denisgav/STM32F405RGT6_BlackPill/doc/production/Impedance Control.odt

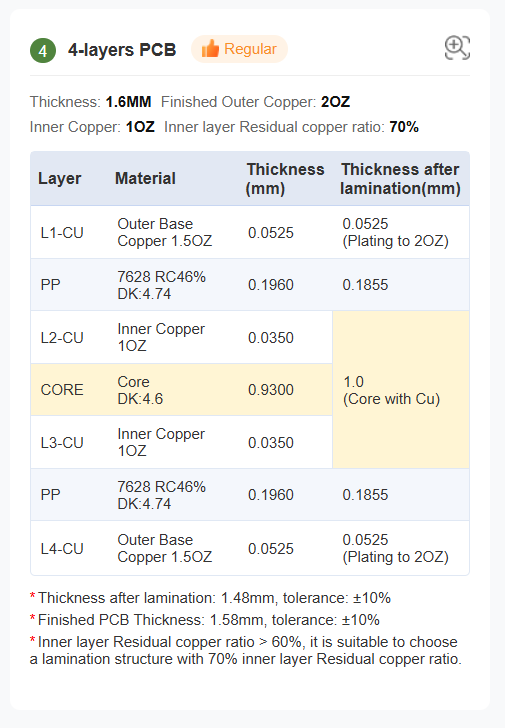
[picture p1: figure]
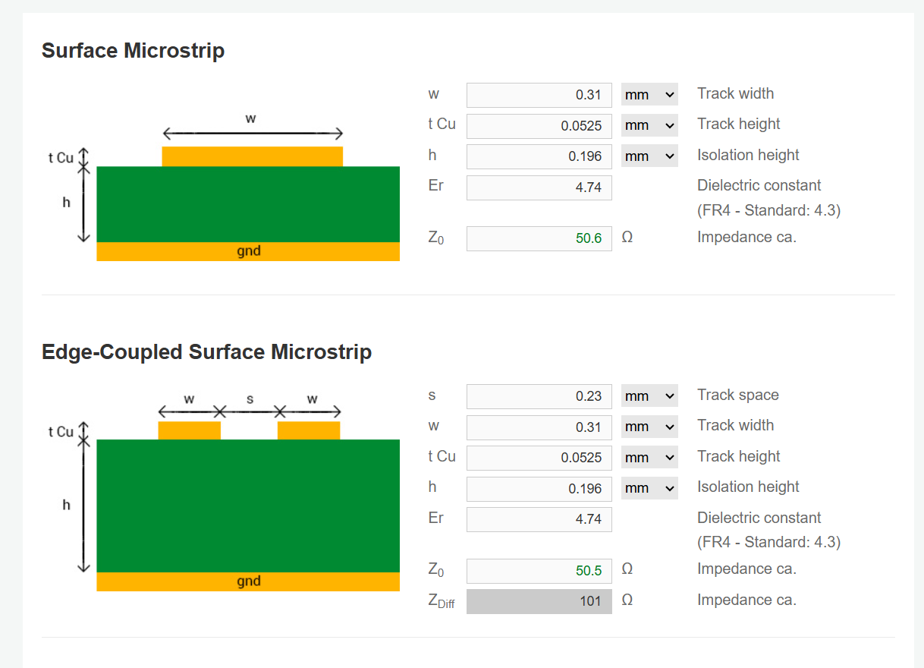
[picture p2: figure]
