denisgav/STM32F405RGT6_BlackPill/STM32F405RGT6_BlackPill/components/HRO  TYPE-C-31-M-12.step

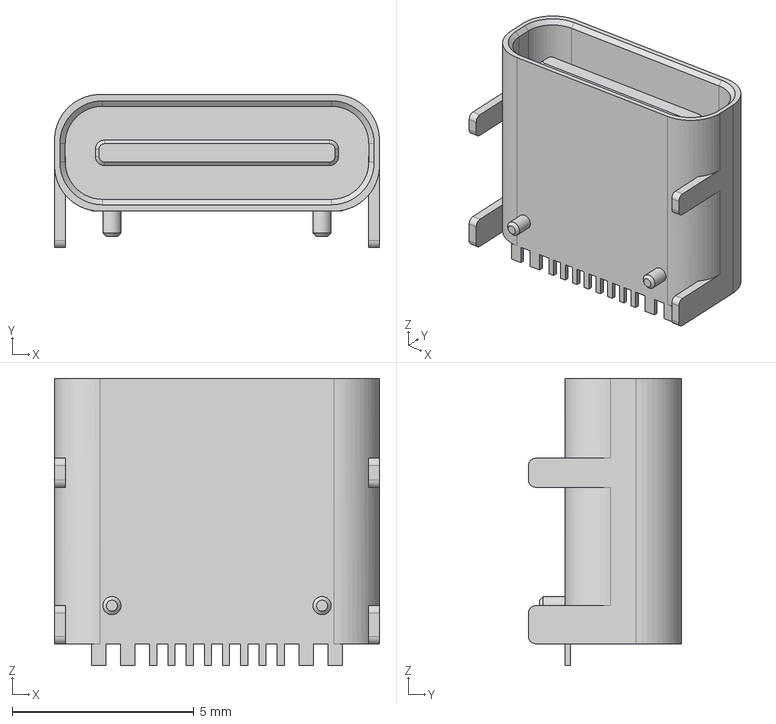
[picture p3: CAD file, 2024-12-23]
STM32F405RGT6_BlackPill/components/HRO TYPE-C-31-M-12.step
8.94 x 4.21 x 7.90 mm
