denisgav/STM32F405RGT6_BlackPill/STM32F405RGT6_BlackPill/components/SMT_0-2P-T001_TDK.step

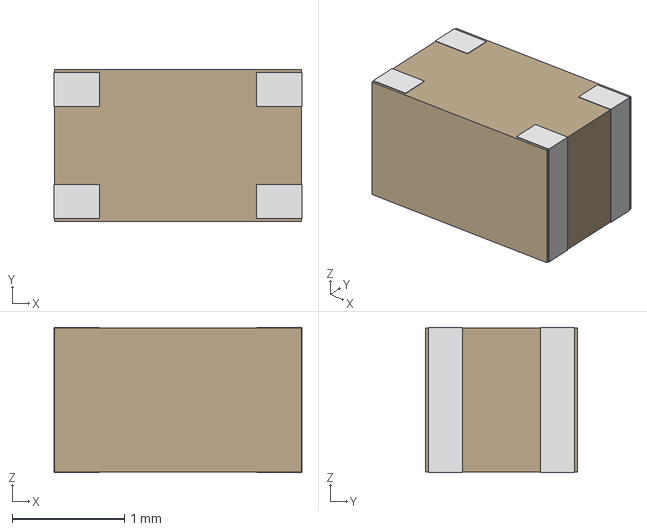
[picture p4: CAD file, 2024-12-23]
STM32F405RGT6_BlackPill/components/SMT_0-2P-T001_TDK.step
2.21 x 1.36 x 1.29 mm
