denisgav/STM32F405RGT6_BlackPill/STM32F405RGT6_BlackPill/components/SW_PUSH_6mm_H5mm.step

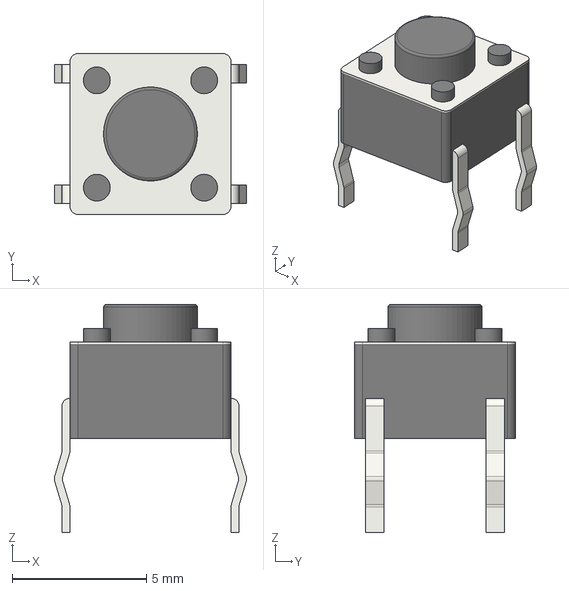
[picture p5: CAD file, 2024-12-22]
STM32F405RGT6_BlackPill/components/SW_PUSH_6mm_H5mm.step
7.17 x 6.00 x 8.50 mm
