denisgav/STM32F405RGT6_BlackPill/STM32F405RGT6_BlackPill/components/12402012E212A.step

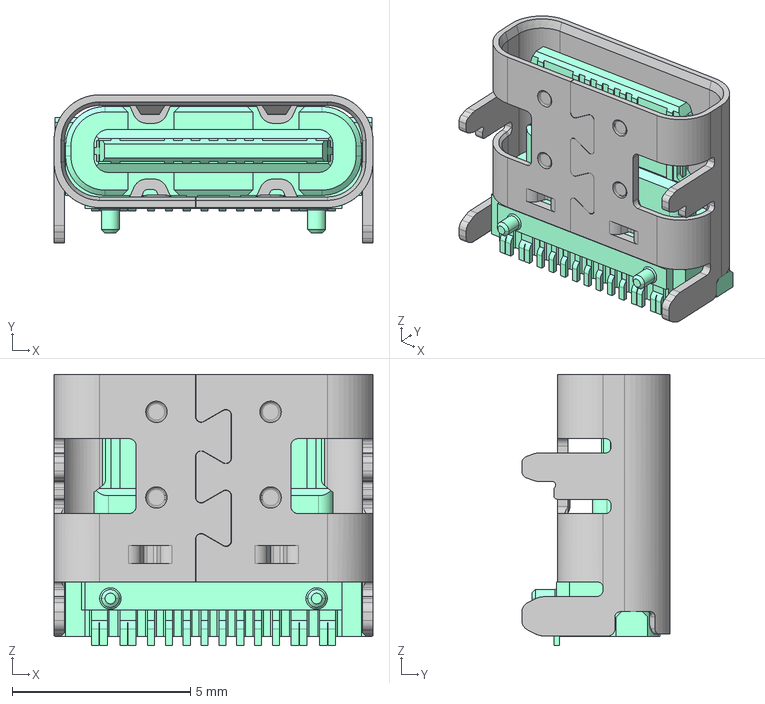
[picture p6: CAD file, 2024-12-23]
STM32F405RGT6_BlackPill/components/12402012E212A.step
8.94 x 4.16 x 7.60 mm
