denisgav/STM32F405RGT6_BlackPill/STM32F405RGT6_BlackPill/STM32F405RGT6_BlackPill.kicad_pcb

## KiCad design STM32F405RGT6_BlackPill/STM32F405RGT6_BlackPill.kicad_pcb (2024-12-26)

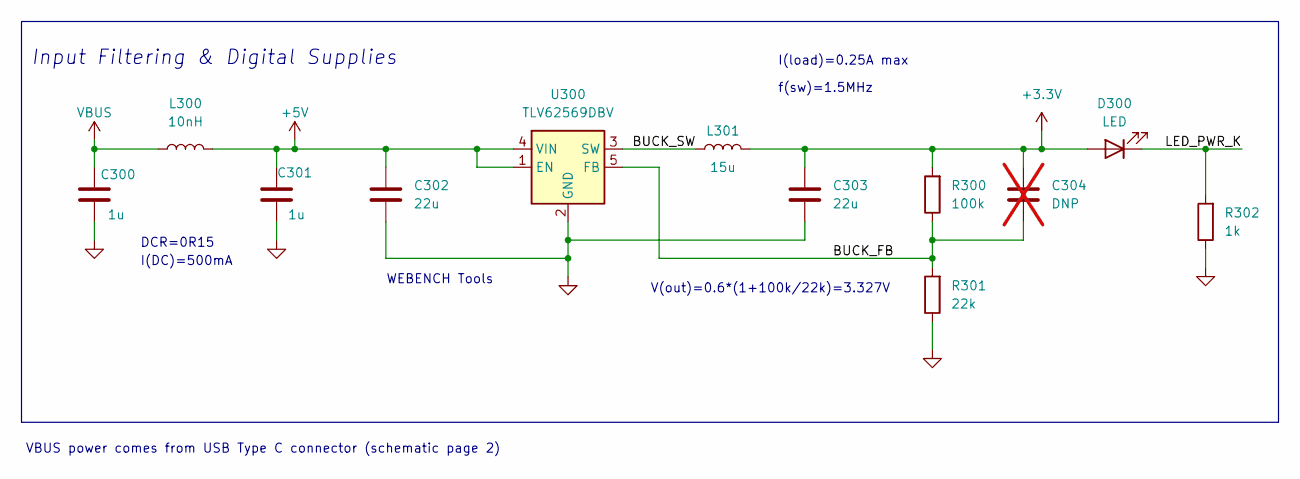
[picture p7: schematic power.kicad_sch]

Parts:
C300, C301: 1u; C_0603_1608Metric; DigiKey Part Number 1276-1946-6-ND
C302, C303: 22u; C_0805_2012Metric; DigiKey Part Number 1276-6687-6-ND
C304: DNP; C_0402_1005Metric; not fitted
D300: LED; LED_0603_1608Metric; DigiKey Part Number 732-4971-6-ND
L300: 10nH; L_0402_1005Metric; DigiKey Part Number 712-LRC0402CJ10NGV001TDKR-ND
L301: 15u; MWSA0603S; DigiKey Part Number 3442-MWSA0603S-150MTDKR-ND
R300: 100k; R_0402_1005Metric; DigiKey Part Number P100KLDKR-ND
R301: 22k; R_0402_1005Metric; DigiKey Part Number P22.0KLDKR-ND
R302: 1k; R_0402_1005Metric; DigiKey Part Number P1.00KLDKR-ND
U300: TLV62569DBV; SOT-23-5; DigiKey Part Number 296-47360-6-ND

Connections:
+3.3V: C303.1, C304.1, D300.2 (A), L301.2, R300.2; also elsewhere on the board
+5V: C301.1, C302.1, L300.2, U300.1 (EN), U300.4 (VIN); also elsewhere on the board
/power/BUCK_FB: C304.2, R300.1, R301.2, U300.5 (FB)
/power/BUCK_SW: L301.1, U300.3 (SW)
/power/LED_PWR_K: D300.1 (K), R302.2
GND: C300.2, C301.2, C302.2, C303.2, R301.1, R302.1, U300.2 (GND); also elsewhere on the board
VBUS: C300.1, L300.1; also elsewhere on the board

Notes on the sheet:
f(sw)=1.5MHz
V(out)=0.6*(1+100k/22k)=3.327V
VBUS power comes from USB Type C connector (schematic page 2)
I(load)=0.25A max
DCR=0R15
WEBENCH Tools
Input Filtering & Digital Supplies
I(DC)=500mA

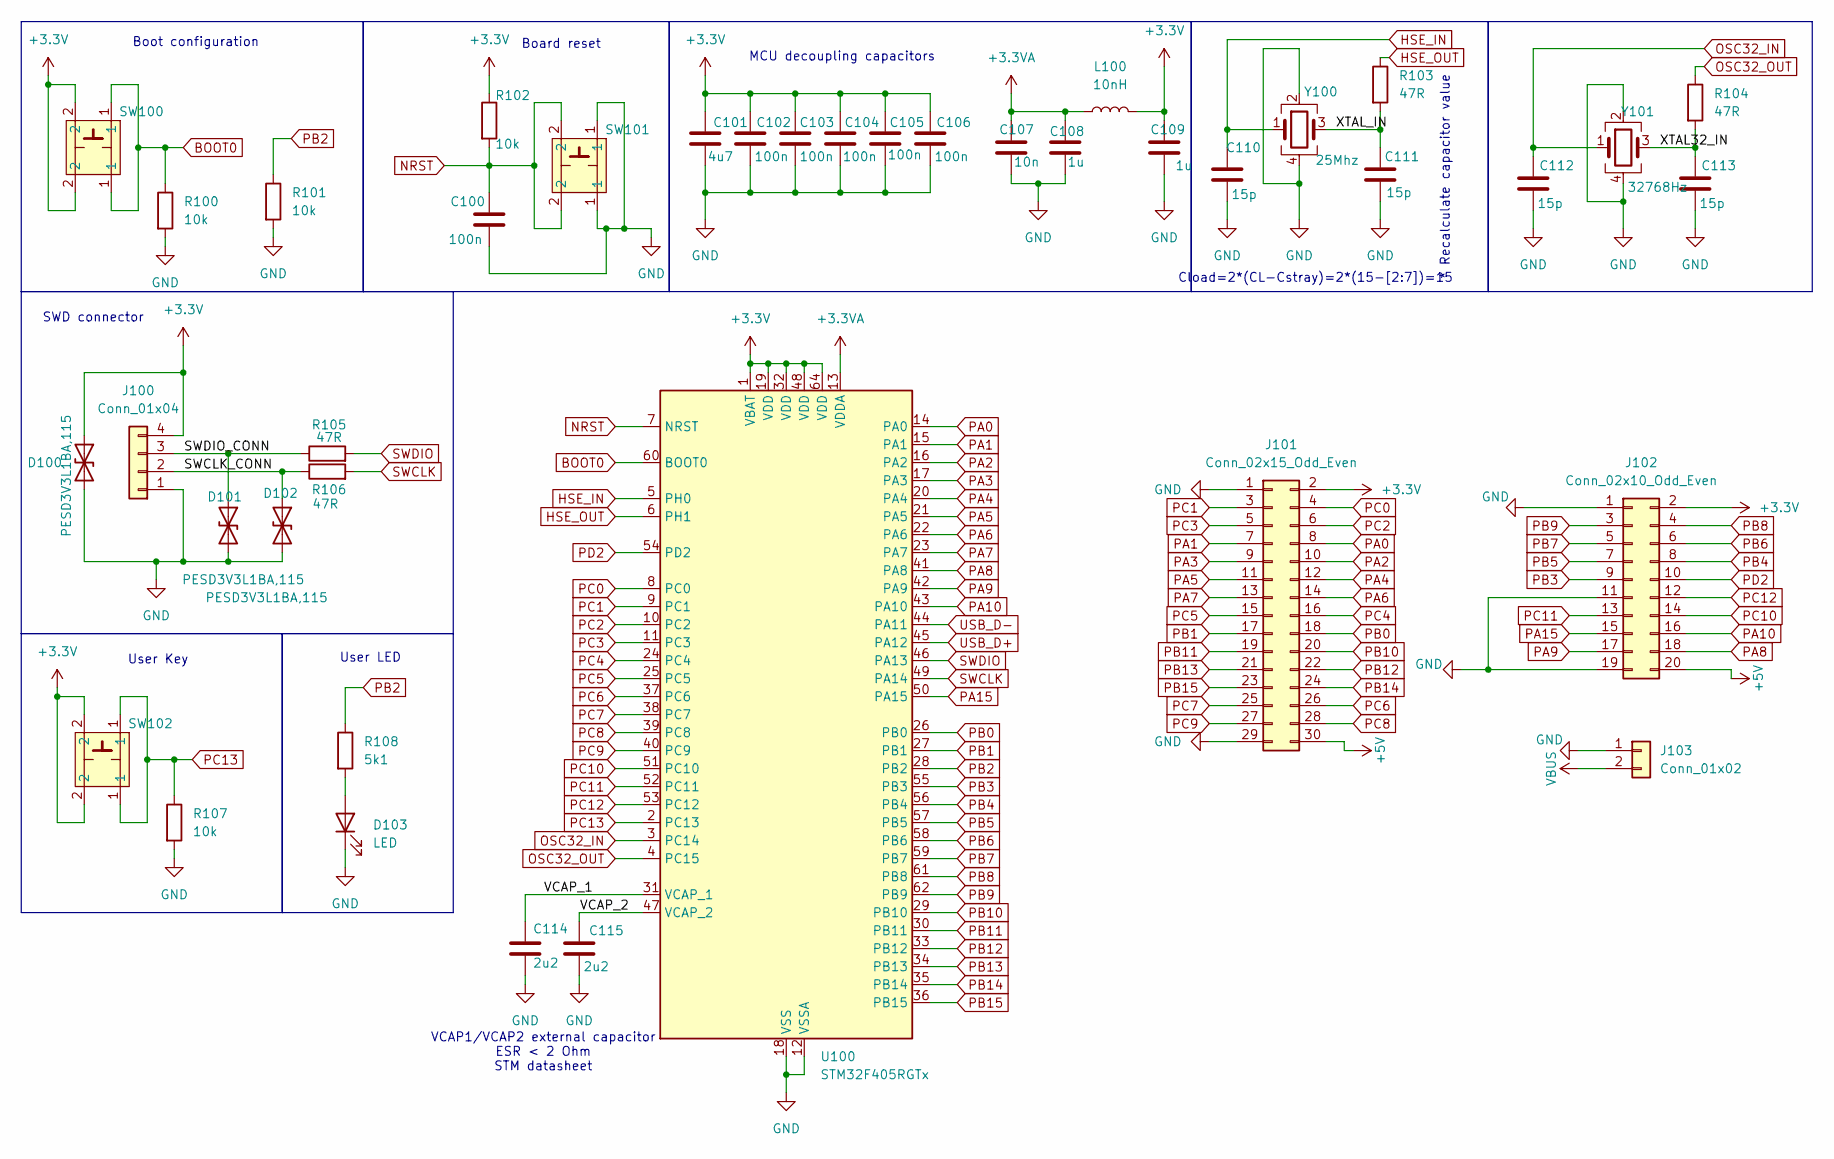
[picture p8: schematic MCU.kicad_sch]

Parts:
C100, C102, C103, C104, C105, C106: 100n; C_0402_1005Metric; DigiKey Part Number 1276-1002-6-ND
C101: 4u7; C_0603_1608Metric; DigiKey Part Number 1276-1044-6-ND
C107: 10n; C_0402_1005Metric; DigiKey Part Number 1276-1028-6-ND
C108, C109: 1u; C_0603_1608Metric; DigiKey Part Number 1276-1946-6-ND
C110, C111, C112, C113: 15p; C_0402_1005Metric; DigiKey Part Number 490-11191-6-ND
C114, C115: 2u2; C_0805_2012Metric; DigiKey Part Number 445-1420-6-ND
D100, D101, D102: PESD3V3L1BA,115; D_SOD-323; DigiKey Part Number 1727-3825-6-ND
D103: LED; LED_0603_1608Metric; DigiKey Part Number 732-4971-6-ND
J100: Conn_01x04; PinHeader_1x04_P2.54mm_Vertical
J101: Conn_02x15_Odd_Even; PinHeader_2x15_P2.54mm_Vertical
J102: Conn_02x10_Odd_Even; PinHeader_2x10_P2.54mm_Vertical
J103: Conn_01x02; PinHeader_1x02_P2.54mm_Vertical
L100: 10nH; L_0402_1005Metric; DigiKey Part Number 712-LRC0402CJ10NGV001TDKR-ND
R100, R101, R102, R107: 10k; R_0402_1005Metric; DigiKey Part Number 1276-3431-6-ND
R103, R104, R105, R106: 47R; R_0402_1005Metric; DigiKey Part Number P47JDKR-ND
R108: 5k1; R_0402_1005Metric; DigiKey Part Number P5.1KDCDKR-ND
SW100, SW101, SW102: SW_PUSH_6mm
U100: STM32F405RGTx; LQFP-64_10x10mm_P0.5mm; DigiKey Part Number 497-11767-ND
Y100: 25Mhz; Crystal_SMD_3225-4Pin_3.2x2.5mm; DigiKey Part Number 535-ASE-25.000MHZ-L-C-TDKR-ND
Y101: 32768Hz; Crystal_SMD_3225-4Pin_3.2x2.5mm; DigiKey Part Number 535-ASEK-32.768KHZ-L-R-TDKR-ND

Connections:
+3.3V: C101.1, C102.1, C103.1, C104.1, C105.1, C106.1, C109.1, D100.1 (A1), J100.4, J101.2, J102.2, L100.2, R102.1, SW100.2, SW102.2, U100.1 (VBAT), U100.19 (VDD), U100.32 (VDD), U100.48 (VDD), U100.64 (VDD); also elsewhere on the board
+3.3VA: C107.1, C108.1, L100.1, U100.13 (VDDA)
+5V: J101.30, J102.20; also elsewhere on the board
/MCU/SWCLK_CONN: D102.1 (A1), J100.2, R106.1
/MCU/SWDIO_CONN: D101.1 (A1), J100.3, R105.1
/MCU/VCAP_1: C114.1, U100.31 (VCAP_1)
/MCU/VCAP_2: C115.1, U100.47 (VCAP_2)
/MCU/XTAL32_IN: C113.1, R104.2, Y101.3
/MCU/XTAL_IN: C111.1, R103.2, Y100.3
BOOT0: R100.1, SW100.1, U100.60 (BOOT0)
GND: C100.2, C101.2, C102.2, C103.2, C104.2, C105.2, C106.2, C107.2, C108.2, C109.2, C110.2, C111.2, C112.2, C113.2, C114.2, C115.2, D100.2 (A2), D101.2 (A2), D102.2 (A2), D103.1 (K), J100.1, J101.1, J101.29, J102.1, J102.11, J102.19, J103.1, R100.2, R101.2, R107.2, SW101.1, U100.12 (VSSA), U100.18 (VSS), U100.63 (VSS), Y100.2, Y100.4, Y101.2, Y101.4; also elsewhere on the board
HSE_IN: C110.1, U100.5 (PH0), Y100.1
HSE_OUT: R103.1, U100.6 (PH1)
NRST: C100.1, R102.2, SW101.2, U100.7 (NRST)
unnamed: D103.2 (A), R108.2
OSC32_IN: C112.1, U100.3 (PC14), Y101.1
OSC32_OUT: R104.1, U100.4 (PC15)
PA0: J101.8, U100.14 (PA0)
PA1: J101.7, U100.15 (PA1)
PA2: J101.10, U100.16 (PA2)
PA3: J101.9, U100.17 (PA3)
PA4: J101.12, U100.20 (PA4)
PA5: J101.11, U100.21 (PA5)
PA6: J101.14, U100.22 (PA6)
PA7: J101.13, U100.23 (PA7)
PA8: J102.18, U100.41 (PA8)
PA9: J102.17, U100.42 (PA9)
PA10: J102.16, U100.43 (PA10)
PA15: J102.15, U100.50 (PA15)
PB0: J101.18, U100.26 (PB0)
PB1: J101.17, U100.27 (PB1)
PB2: R101.1, R108.1, U100.28 (PB2)
PB3: J102.9, U100.55 (PB3)
PB4: J102.8, U100.56 (PB4)
PB5: J102.7, U100.57 (PB5)
PB6: J102.6, U100.58 (PB6)
PB7: J102.5, U100.59 (PB7)
PB8: J102.4, U100.61 (PB8)
PB9: J102.3, U100.62 (PB9)
PB10: J101.20, U100.29 (PB10)
PB11: J101.19, U100.30 (PB11)
PB12: J101.22, U100.33 (PB12)
PB13: J101.21, U100.34 (PB13)
PB14: J101.24, U100.35 (PB14)
PB15: J101.23, U100.36 (PB15)
PC0: J101.4, U100.8 (PC0)
PC1: J101.3, U100.9 (PC1)
PC2: J101.6, U100.10 (PC2)
PC3: J101.5, U100.11 (PC3)
PC4: J101.16, U100.24 (PC4)
PC5: J101.15, U100.25 (PC5)
PC6: J101.26, U100.37 (PC6)
PC7: J101.25, U100.38 (PC7)
PC8: J101.28, U100.39 (PC8)
PC9: J101.27, U100.40 (PC9)
PC10: J102.14, U100.51 (PC10)
PC11: J102.13, U100.52 (PC11)
PC12: J102.12, U100.53 (PC12)
PC13: R107.1, SW102.1, U100.2 (PC13)
PD2: J102.10, U100.54 (PD2)
SWCLK: R106.2, U100.49 (PA14)
SWDIO: R105.2, U100.46 (PA13)
USB_D+: U100.45 (PA12); also elsewhere on the board
USB_D-: U100.44 (PA11); also elsewhere on the board
VBUS: J103.2; also elsewhere on the board

Notes on the sheet:
Cload=2*(CL-Cstray)=2*(15-[2:7])=15
MCU decoupling capacitors
VCAP1/VCAP2 external capacitor ESR < 2 Ohm STM datasheet
Board reset
User Key
SWD connector
User LED
* Recalculate capacitor value
Boot configuration

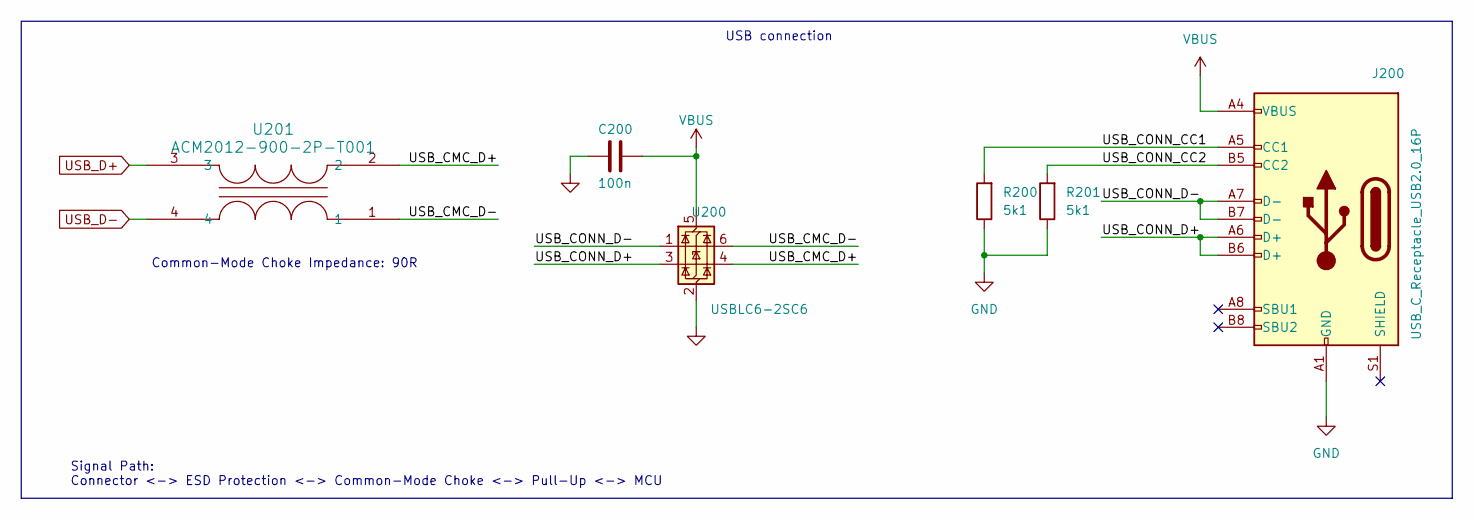
[picture p9: schematic usb.kicad_sch]

Parts:
C200: 100n; C_0402_1005Metric; DigiKey Part Number 1276-1002-6-ND
J200: USB_C_Receptacle_USB2.0_16P; USB_C_Receptacle_HCTL_HC-TYPE-C-16P-01A; DigiKey Part Number 664-12402012E212ADKR-ND
R200, R201: 5k1; R_0402_1005Metric; DigiKey Part Number P5.1KDCDKR-ND
U200: USBLC6-2SC6; SOT-23-6; DigiKey Part Number 497-5235-6-ND
U201: ACM2012-900-2P-T001; SMT_0-2P-T001_TDK; DigiKey Part Number 445-15969-6-ND

Connections:
/USB/USB_CMC_D+: U200.4 (I/O2), U201.2
/USB/USB_CMC_D-: U200.6 (I/O1), U201.1
/USB/USB_CONN_CC1: J200.A5 (CC1), R200.2
/USB/USB_CONN_CC2: J200.B5 (CC2), R201.2
/USB/USB_CONN_D+: J200.A6 (D+), J200.B6 (D+), U200.3 (I/O2)
/USB/USB_CONN_D-: J200.A7 (D-), J200.B7 (D-), U200.1 (I/O1)
GND: C200.2, J200.A1 (GND), J200.A12 (GND), J200.B1 (GND), J200.B12 (GND), R200.1, R201.1, U200.2 (GND); also elsewhere on the board
USB_D+: U201.3; also elsewhere on the board
USB_D-: U201.4; also elsewhere on the board
VBUS: C200.1, J200.A4 (VBUS), J200.A9 (VBUS), J200.B4 (VBUS), J200.B9 (VBUS), U200.5 (VBUS); also elsewhere on the board

Notes on the sheet:
Signal Path: Connector <-> ESD Protection <-> Common-Mode Choke <-> Pull-Up <-> MCU
USB connection
Common-Mode Choke Impedance: 90R

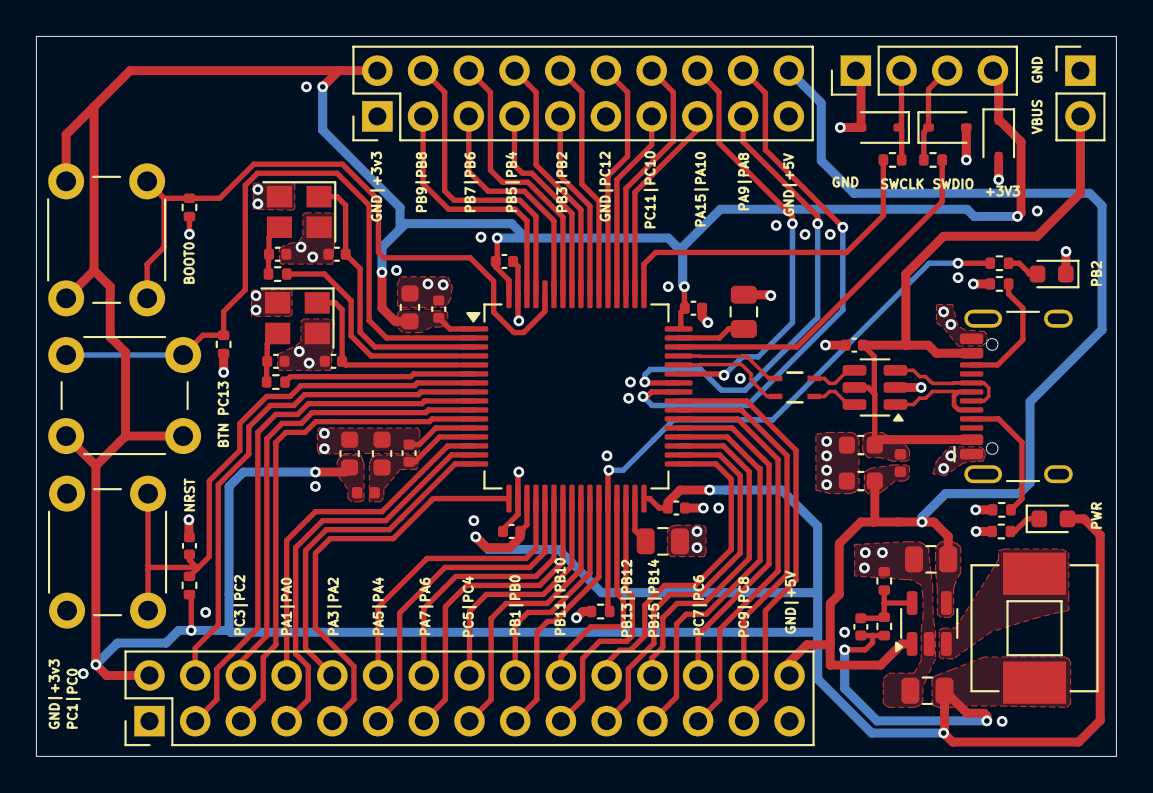
[picture p10: board STM32F405RGT6_BlackPill.kicad_pcb from above]

Board: 4 copper layers, 60.0 x 40.0 mm, 58 parts (0 on the bottom side), 74 nets.
