denisgav/STM32F405RGT6_BlackPill/(commit log)

2024-12-23 Add power and USB scheme
    [MCU.kicad_sch, STM32F405RGT6_BlackPill.kicad_sch, power.kicad_sch, usb.kicad_sch]
2024-12-23 First version of the scheme
    [MCU.kicad_sch, usb.kicad_sch]
2024-12-23 Essential part of the BOM fill
    [MCU.kicad_sch, SMT_0-2P-T001_TDK.step, STM32F405RGT6_BlackPill.kicad_pcb, power.kicad_sch, usb.kicad_sch]
2024-12-23 BOM table fill
    [MCU.kicad_sch, power.kicad_sch, usb.kicad_sch]
2024-12-23 Initial components placement
    [12402012E212A.step, HRO TYPE-C-31-M-12.step, MCU.kicad_sch, STM32F405RGT6_BlackPill.kicad_pcb]
2024-12-24 Border outline
    [STM32F405RGT6_BlackPill.kicad_pcb]
2024-12-24 Signal routing (bottom part)
    [MCU.kicad_sch, STM32F405RGT6_BlackPill.kicad_pcb, power.kicad_sch]
2024-12-24 Signal routing (upper part)
    [MCU.kicad_sch, STM32F405RGT6_BlackPill.kicad_pcb]
2024-12-24 Minor DCR fixes
    [STM32F405RGT6_BlackPill.kicad_pcb]
2024-12-24 All signals routed
    [STM32F405RGT6_BlackPill.kicad_pcb]
2024-12-25 VBUS | GND connector, manufacture files
    [MCU.kicad_sch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]
2024-12-25 Add BOM file
    [MCU.kicad_sch, STM32F405RGT6_BlackPill.csv]
2024-12-26 Production files JLCPCB
    [MCU.kicad_sch, STM32F405RGT6_BlackPill - Copy.csv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]
